FacZap/SCH_PCB_BateriaDeArena/_restore_backup_2026-08-05T16-04-41-681/entregables/correccion DCR.docx

El único error arrojado por el DRC correspondía a un incumplimiento del ancho de anillo anular mínimo en los 5 pads de U2 (regulador LM2596). El pad tenía un tamaño en X de 1,275 mm sobre un agujero de 1,1 mm, resultando en un anillo real de 0,0875 mm, por debajo del mínimo configurado de 0,1 mm.

Error: Ancho de anular (restricciones de configuración de placa ancho anular min 0, 1 (m mm: real 0,0875 mm

La corrección consistió en modificar el footprint de U2, aumentando el tamaño X del pad de 1,275 mm a 1,5 mm (manteniendo el agujero en 1,1 mm), llevando el anillo anular a 0,2 mm y cumpliendo así la regla de diseño. Tras actualizar el PCB desde el esquema, el DRC se ejecutó nuevamente sin errores.

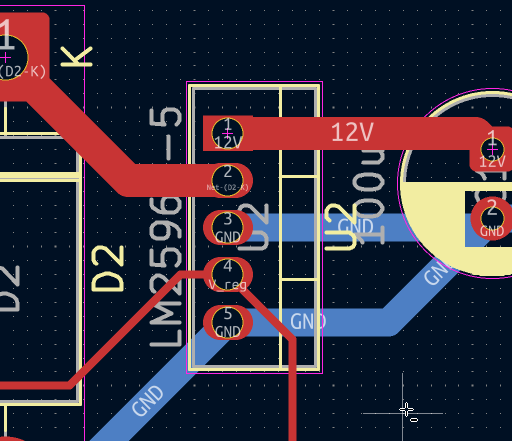
[picture p1: figure]
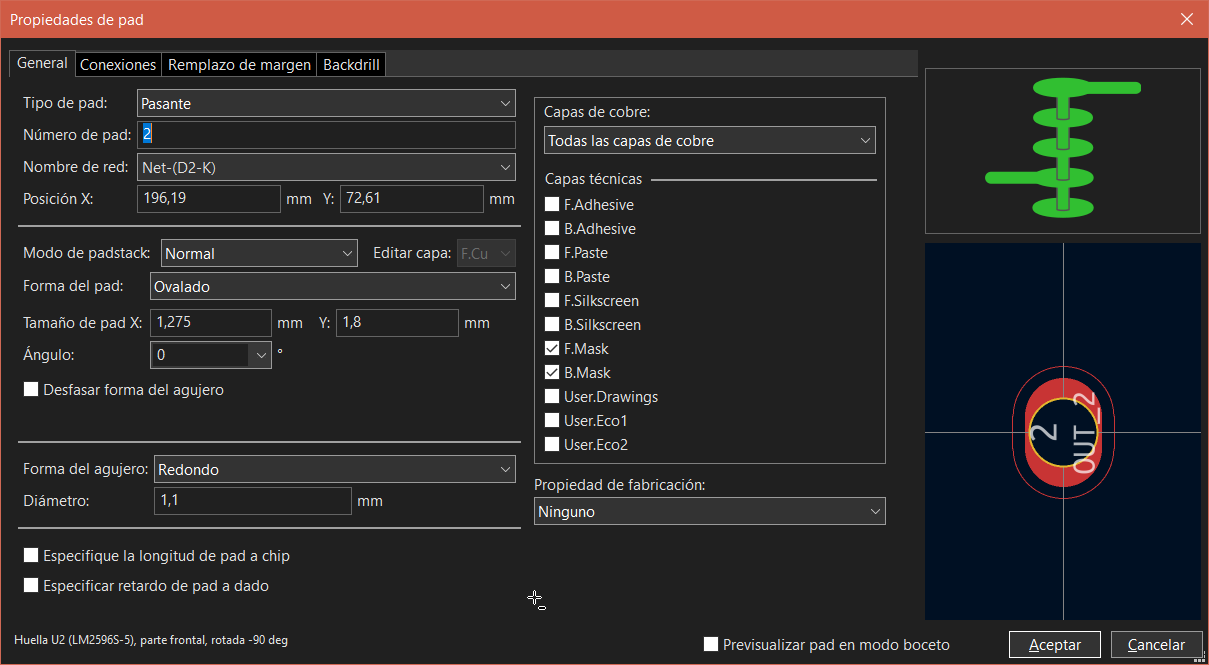
[picture p2: figure]
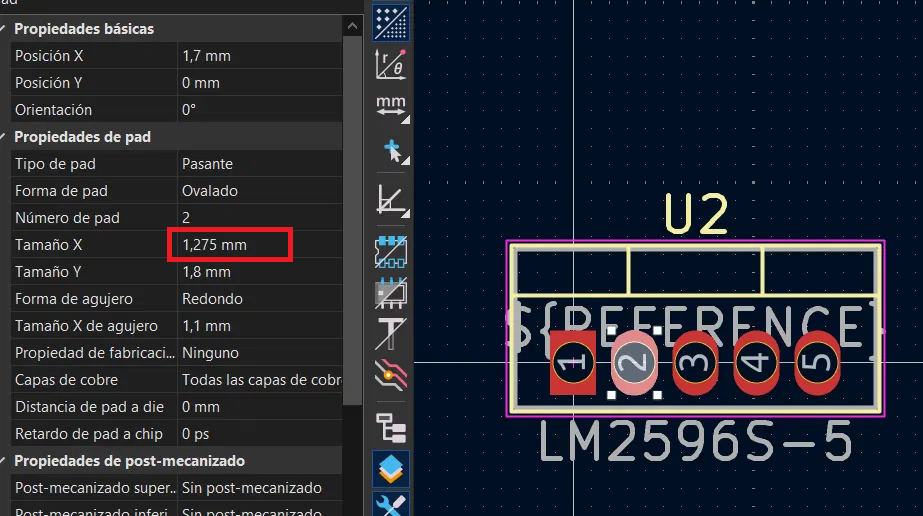
[picture p3: figure]
