FacZap/SCH_PCB_BateriaDeArena/Informe técnico EFIO.docx

Informe técnico — Evaluación Final Integradora

Zapata Facundo

Proyecto: Placa de control para batería de arena (ESP32)

Alcance: placa de una sola cara (simple faz), pasivos R1-R5 y C1-C2 en SMD 1206 / electrolítico SMD, resto de los componentes en THT, prevista para fabricación artesanal sobre FR4.
A continuación se justifican las decisiones de diseño y fabricación adoptadas.

Sustrato. Se eligió FR4 frente a los laminados fenólicos (FR1/FR2). El refuerzo de fibra de vidrio tejida le da mayor rigidez mecánica y resistencia a la vibración, su temperatura de transición vítrea (Tg = 140 °C) es sensiblemente superior a la del fenólico (~105-120 °C), y absorbe menos humedad. En una placa que maneja una carga resistiva de 5 A y disipa calor en la etapa de potencia, esa mayor estabilidad térmica y la mejor durabilidad de los agujeros bajo ciclado térmico son determinantes: el fenólico no ofrece garantías equivalentes.

Número de capas. El diseño se resolvió en una sola capa de cobre. Una auditoría del ruteo de dos capas previo confirmó que la totalidad de los cruces por la cara inferior eran evitables reubicando pistas en la cara superior, de modo que la segunda capa no aportaba valor funcional. Trabajar en simple faz elimina los saltos de capa innecesarios, reduce la cantidad de perforaciones y, sobre todo, simplifica el proyecto y habilita la fabricación artesanal.

Estrategia de masa. El retorno de masa se ruteó con trazas dedicadas en lugar de un plano por relleno de cobre (pour). La decisión prioriza el control manual completo del trazado y la verificación visual directa, ventajas relevantes en una placa hecha por un principiante. El tronco principal de GND se ensanchó para dimensionar el retorno de ~5 A de la carga con margen holgado, y los lazos de retorno del regulador conmutado (LM2596) se mantuvieron cortos para acotar el ruido. Se asume, entonces, una impedancia de retorno algo mayor que la de un plano continuo. El ensanchado del tronco y la contención de los lazos del conmutador mitigan ese compromiso dentro de lo que la aplicación requiere.

Criterio SMD / THT. Los pasivos (resistencias y capacitores) se llevaron a SMD 1206 y electrolítico SMD. Después de investigar las diferencias entre componentes SMDs 0805 y 1206, se prefirió este último ya que ocupan menos superficie y reducen la cantidad de agujeros a perforar manualmente. La etapa de potencia, el inductor, los conectores y las borneras se mantuvieron en THT: soportan mejor el esfuerzo mecánico, toleran la corriente de la carga y son más fáciles de soldar a mano con soldador tipo lápiz cuando manejan potencia. El encapsulado 1206 se prefirió sobre 0805 por su potencial mayor facilidad de manipulación y soldado.

Método de fabricación y acabado. Se especifica fabricación artesanal por transferencia de tóner y ataque con cloruro férrico, con protección final por laca. Para un prototipo de aprendizaje, este método es de bajo costo y rápido de iterar. Una fabricación profesional (máscara antisoldante, PTH, HASL, etc) aportaría mayor robustez y repetibilidad, pero no se justifica para el volumen y el propósito de esta entrega.
