FacZap/SCH_PCB_BateriaDeArena/Hoja_Tecnica_Completada_EFIO.xlsx

Sheet: PCB
PCB Specification
Name: | Controlador batería de arena – ESP32 (V1: simple faz, pasivos SMD)
Board type : | Placa individual, simple faz (single-sided)
Size (single): | 105 × 85 mm
Quantity (single) | 1
Layers: | 1 (una sola cara de cobre)
Material: | FR4, Tg 140 °C
Thickness: | 1.6 mm
Solder mask: | Verde, una cara
Silkscreen: | Blanca, cara de componentes
Surface finish | HASL sin plomo
Finished copper: | 35 µm (1 oz)
Notes: | Diseño THT-dominante con pasivos R1–R5 y C1–C2 en SMD 1206 / electrolítico SMD. Ruteo en una sola capa de cobre. Carga de potencia: nicrom ~5 A (~2.4 Ω) vía bornera, no soldado directo. A usar con ESP32.
Datos de fabricación
Método de fabricación: | Artesanal
Método de transferencia de diseño: | Tóner (transferencia térmica)
Reactivo de ataque químico: | Cloruro férrico
Método de soldado: | Soldador convencional (THT) + aire caliente (SMD 1206)
Tratamiento de aislación final: | Laca (barniz protector)
Costo estimado de insumos ($): | [VER SEGUNDA HOJA]

Sheet: Costo
Costeo de insumos — placa batería de arena (V4, simple faz, artesanal)
Rubro | Detalle | Precio unit. ($) | Cant. | Subtotal ($) | Total ($) | Fuente / Nota
Placa virgen FR4 simple faz | 10x10 (se puede hacer que entre) | 1300 | 1 | 5000 | 5000 | IDE Ingeniería
ESP32 DevKit V1 | Módulo controlador | 12,090 | 1 | 12090 | 12090 | MercadoLibre
Cloruro férrico | Frasco/escamas p/ ataque | 7,000 | 1 | 7000 | 7000 | MercadoLibre
LM2596S-5 | Regulador conmutado TO-220 | 1,500 | 1 | 1500 | 1500 | MercadoLibre
IRLZ44N | MOSFET potencia TO-220 | 1,200 | 1 | 1200 | 1200 | MercadoLibre
BC547 | Transistor drive relé | 150 | 1 | 150 | 150 | MercadoLibre
DS18B20 | Sensor temperatura | 2,500 | 1 | 2500 | 2500 | MercadoLibre
Relé Songle SRD-12VDC-SL-C | Relé 12V 10A | 1,500 | 1 | 1500 | 1500 | MercadoLibre
Inductor 33µH radial | Bobina buck | 600 | 1 | 600 | 600 | Estimado pack de Mercado Libre
Diodo 1N5822 | Schottky | 300 | 1 | 300 | 300 | MercadoLibre
Diodo 1N4007 | Flyback | 50 | 1 | 50 | 50 | MercadoLibre
Disipador TO-220 | Heatsink p/ MOSFET/regulador | 1,500 | 1 | 1500 | 1500 | MercadoLibre
Borneras 2 pines | Screw terminal (J3, J4) | 400 | 2 | 800 | 1600 | Estimado pack de Mercado Libre
Pin headers | Tira 1x19 (J1,J2) + 1x04 (J5) | 500 | 1 | 500 | 500 | Estimado pack de Mercado Libre
Resistencias SMD 1206 | R1–R5 (5 u.) | 250 | 1 | 250 | 250 | Estimado pack de Mercado Libre
Capacitores cerámicos SMD 1206 | 100 nF | 200 | 1 | 200 | 200 | Estimado pack de Mercado Libre
Capacitores electrolíticos SMD | 100 µF + 220 µF | 1,000 | 1 | 1000 | 1000 | Estimado pack de Mercado Libre
Insumos artesanales | Estaño + papel transfer + laca + fibra | 3,000 | 1 | 3000 | 3000 | Estimado "a ojo"
TOTAL estimado |  |  |  |  | 39940 | aprox. 40mil ARS
