FacZap/SCH_PCB_BateriaDeArena/_restore_backup_2026-08-05T16-04-41-681/pdf/PDF.pdf

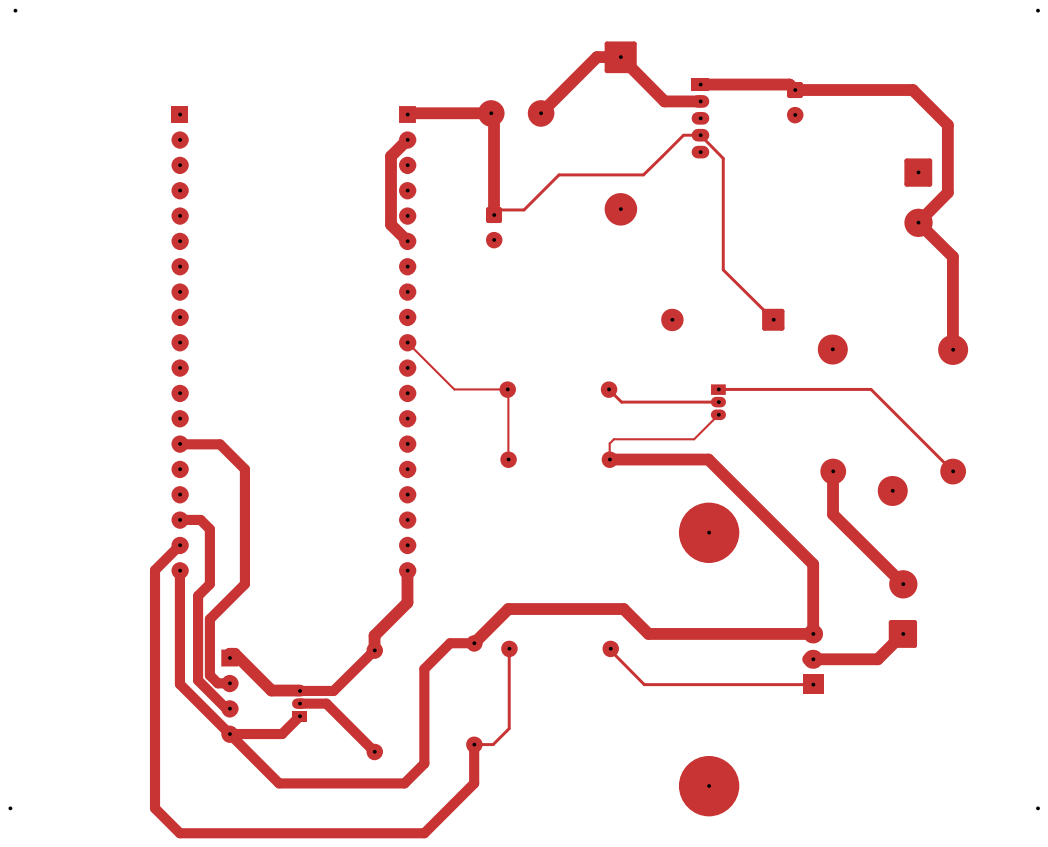
[picture p4: page 1]

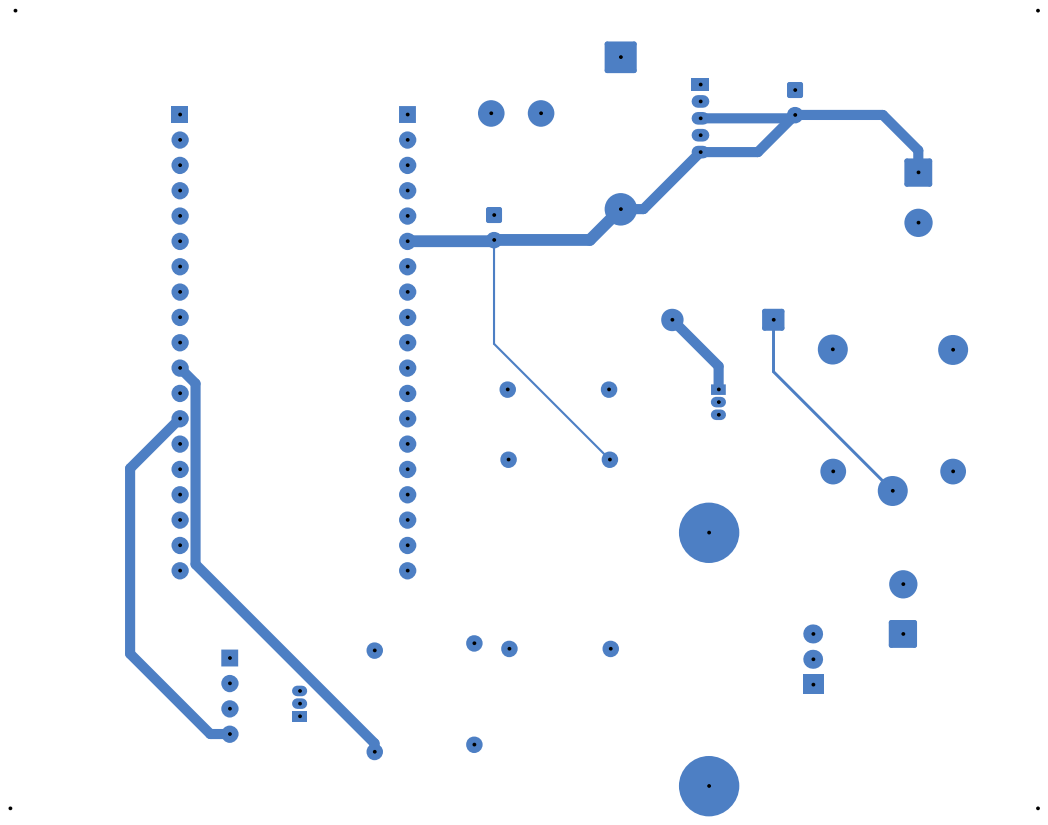
[picture p5: page 2]

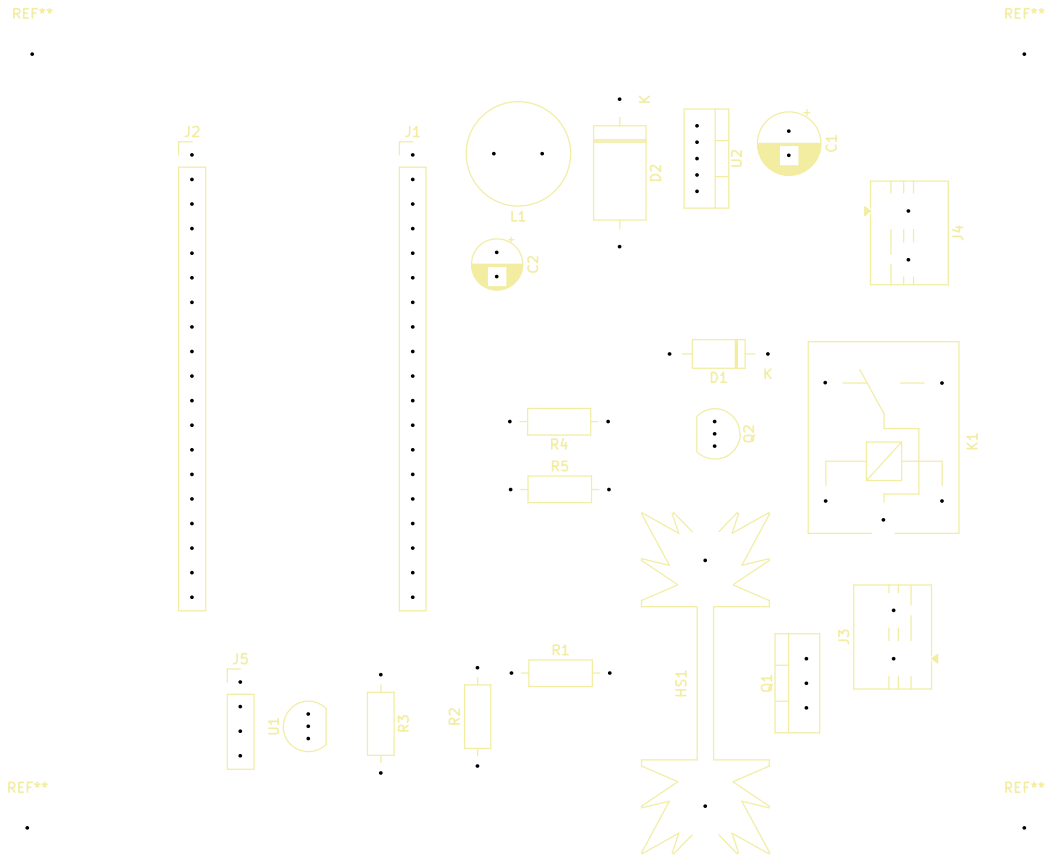
[picture p6: page 3]

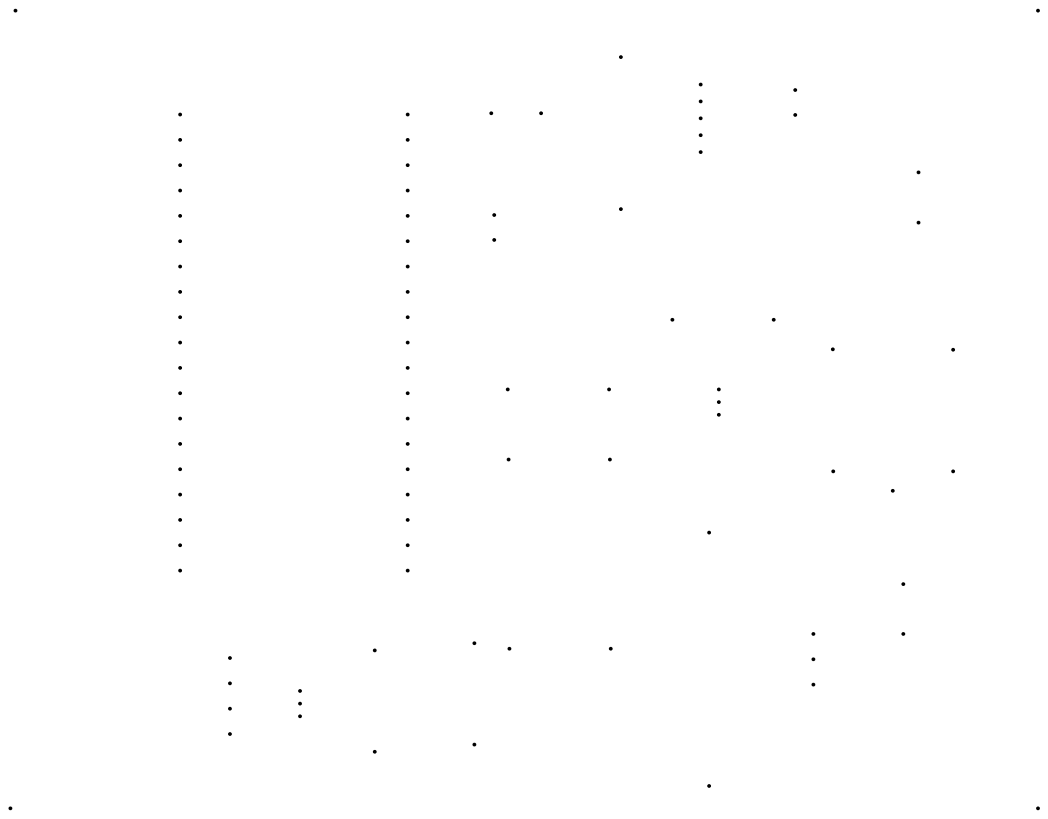
[picture p7: page 4]

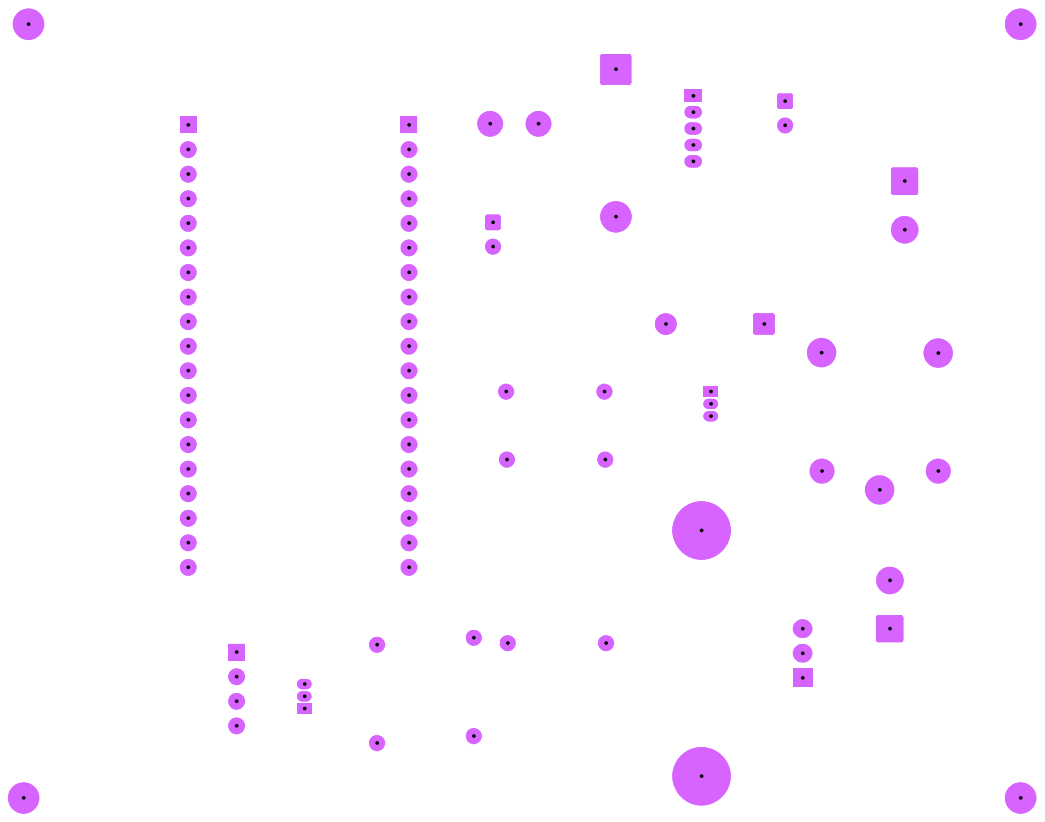
[picture p8: page 5]

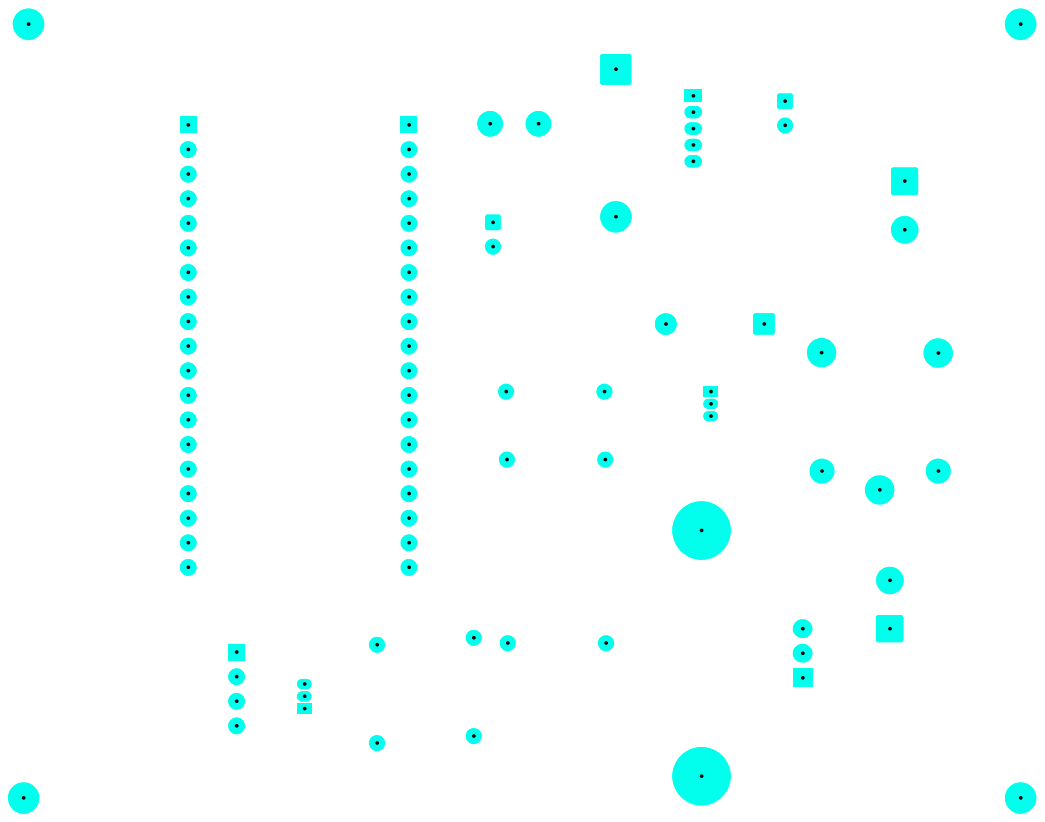
[picture p9: page 6]
