FacZap/SCH_PCB_BateriaDeArena/_restore_backup_2026-08-05T16-04-41-681/ProyectoTransversal.kicad_pcb

## KiCad design _restore_backup_2026-08-05T16-04-41-681/ProyectoTransversal.kicad_pcb (2026-08-05)

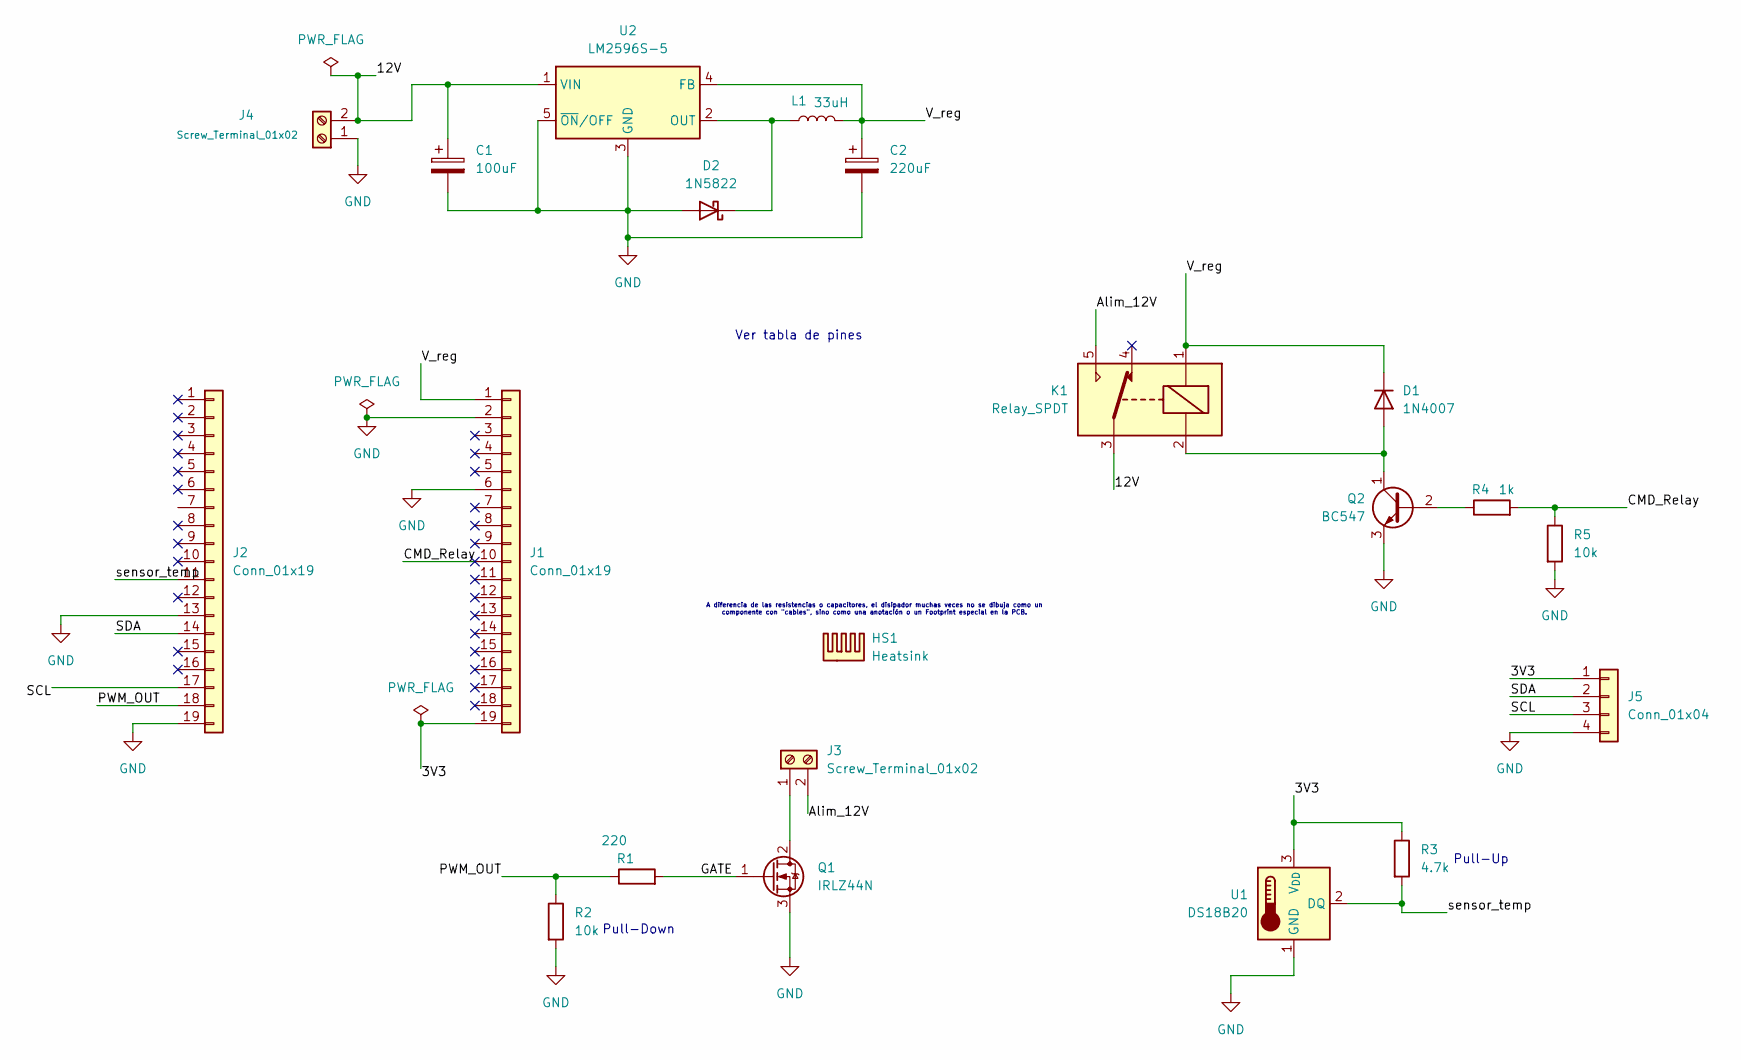
[picture p10: schematic ProyectoTransversal.kicad_sch]

Parts:
C1: 100uF; CP_Elec_6.3x7.7
C2: 220uF; CP_Elec_8x10.5
D1: 1N4007; D_DO-41_SOD81_P10.16mm_Horizontal
D2: 1N5822; D_DO-201AD_P15.24mm_Horizontal
HS1: Heatsink; Heatsink_Fischer_SK104-STC-STIC_35x13mm_2xDrill2.5mm
J1, J2: Conn_01x19; PinHeader_1x19_P2.54mm_Vertical
J3, J4: Screw_Terminal_01x02; TerminalBlock_MaiXu_MX126-5.0-02P_1x02_P5.00mm
J5: Conn_01x04; PinHeader_1x04_P2.54mm_Vertical
K1: Relay_SPDT; Relay_SPDT_SANYOU_SRD_Series_Form_C
L1: 33uH; L_Radial_D10.5mm_P5.00mm_Abacron_AISR-01
Q1: IRLZ44N; TO-220-3_Vertical
Q2: BC547; TO-92_Inline
R1: 220; R_1206_3216Metric
R2, R5: 10k; R_1206_3216Metric
R3: 4.7k; R_1206_3216Metric
R4: 1k; R_1206_3216Metric
U1: DS18B20; TO-92_Inline
U2: LM2596S-5; TO-220-5_Vertical

Connections:
/3V3: J1.19, J5.1, R3.1, U1.3 (V_{DD})
/12V: C1.1, J4.2, K1.3, U2.1 (VIN)
/Alim_12V: J3.2, K1.5
/CMD_Relay: J1.10, R4.2, R5.1
/GATE: Q1.1 (G), R1.2
/PWM_OUT: J2.18, R1.1, R2.1
/SCL: J2.17, J5.3
/SDA: J2.14, J5.2
/V_reg: C2.1, D1.1 (K), J1.1, K1.1, L1.2, U2.4 (FB)
/sensor_temp: J2.11, R3.2, U1.2 (DQ)
GND: C1.2, C2.2, D2.2 (A), J1.2, J1.6, J2.13, J2.19, J4.1, J5.4, Q1.3 (S), Q2.3 (E), R2.2, R5.2, U1.1 (GND), U2.3 (GND), U2.5 (~ON/OFF)
unnamed: D1.2 (A), K1.2, Q2.1 (C)
unnamed: D2.1 (K), L1.1, U2.2 (OUT)
unnamed: J3.1, Q1.2 (D)
unnamed: Q2.2 (B), R4.1

Notes on the sheet:
A diferencia de las resistencias o capacitores, el disipador muchas veces no se dibuja como un componente con "cables", sino como una anotación o un Footprint especial en la PCB.
Pull-Up
Pull-Down
Ver tabla de pines

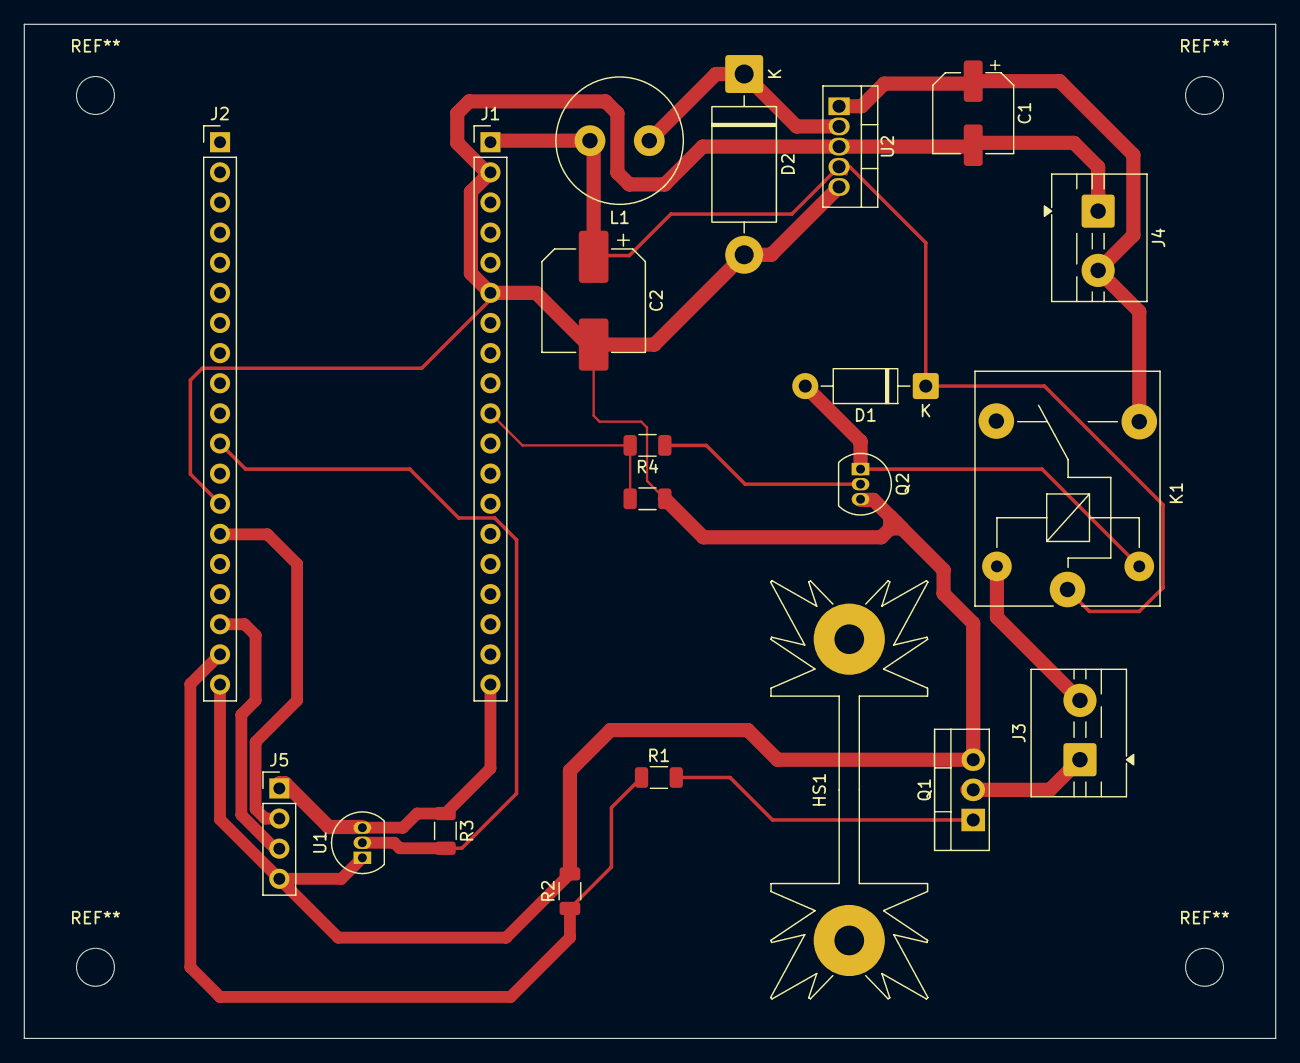
[picture p11: board ProyectoTransversal.kicad_pcb from above]

Board: 2 copper layers, 105.5 x 85.5 mm, 21 parts (0 on the bottom side), 15 nets.
