FacZap/SCH_PCB_BateriaDeArena/(commit log)

2026-06-26 Add more components
    [ProyectoTransversal.kicad_sch]
2026-06-29 Add voltage regulator
    [ProyectoTransversal.kicad_sch]
2026-06-30 Finish PCB connections and ERC
    [ProyectoTransversal.kicad_sch]
2026-07-01 Finish SCH layout
    [ProyectoTransversal.kicad_pcb, ProyectoTransversal.kicad_sch]
2026-07-02 Route voltage regulator
    [ProyectoTransversal.kicad_pcb, ProyectoTransversal.kicad_sch]
2026-07-05 Finish layout
    [ProyectoTransversal.kicad_pcb]
2026-07-05 Add copper GND zone
    [ProyectoTransversal.kicad_pcb]
2026-07-12 Add R5 pull down cmd relay
    [ProyectoTransversal.kicad_pcb, ProyectoTransversal.kicad_sch]
2026-07-13 Begin reroute
    [ProyectoTransversal.kicad_pcb]
2026-07-23 Last changes to WIPM1U4
    [ProyectoTransversal-B_Cu.gbl, ProyectoTransversal-B_Mask.gbs, ProyectoTransversal-B_Paste.gbp, ProyectoTransversal-B_Silkscreen.gbo, ProyectoTransversal-Edge_Cuts.gm1, ProyectoTransversal-F_Cu.gtl, ProyectoTransversal-F_Mask.gts, ProyectoTransversal-F_Paste.gtp]
2026-07-26 Fix pad sizing in U2
    [ProyectoTransversal.kicad_pcb]
2026-08-02 Rework vias to transform PCB into one-sided
    [ProyectoTransversal.kicad_pcb]
2026-08-04 Change C1 C2 and R footprints
    [ProyectoTransversal.kicad_pcb]
2026-08-04 Modify vias
    [ProyectoTransversal.kicad_pcb]
2026-08-04 Finish wiring SMD resistors
    [ProyectoTransversal.kicad_pcb]
2026-08-05 Actualizacion footprints de esquematico
    [ProyectoTransversal.kicad_pcb, ProyectoTransversal.kicad_sch]
2026-08-05 Fix GND width
    [ProyectoTransversal.kicad_pcb]
2026-08-05 Final submission
    [EFIO_BOM.csv, Hoja_Tecnica_Completada_EFIO.xlsx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]
